microrobotics/ESP32-EASY-PROTO-V2/docs/images/ESP32-EASY-PROTO-V2_Assembled_T&B.jpg

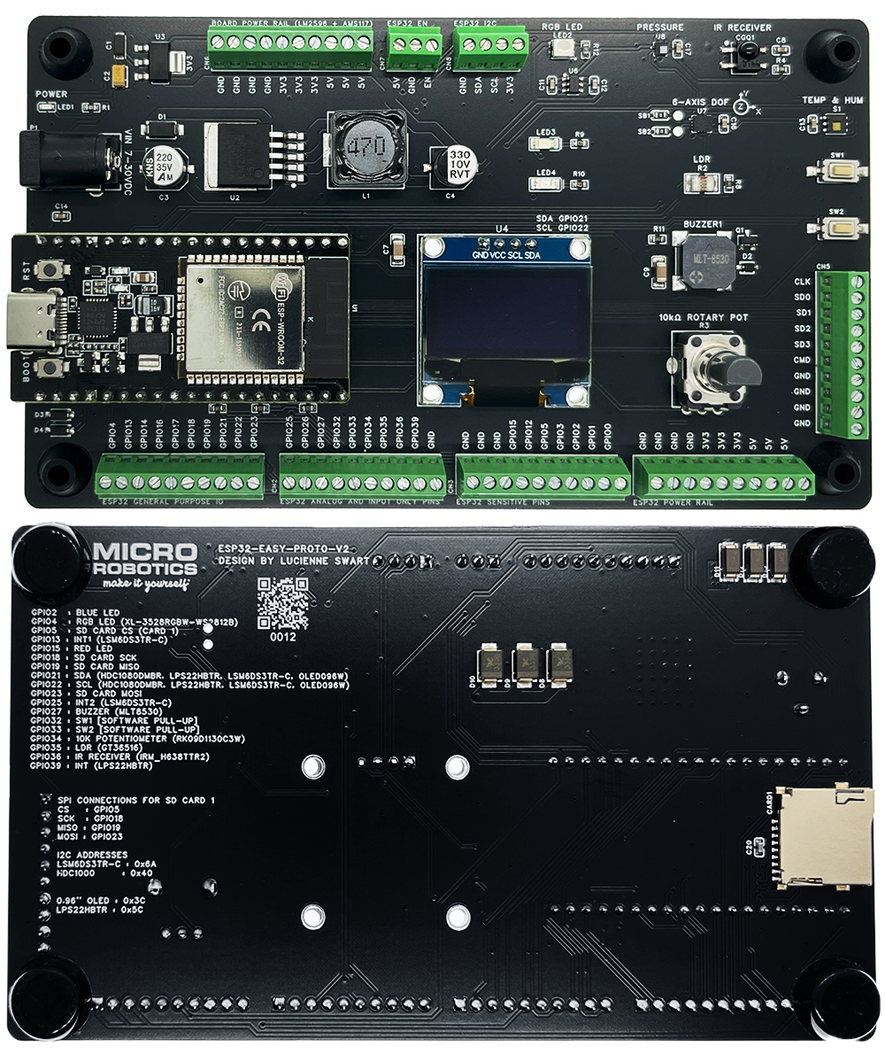
docs/images/ESP32-EASY-PROTO-V2_Assembled_T&B.jpg
