microrobotics/ESP32-EASY-PROTO-V2/hardware/mechanical/drawings/ESP32-EASY-PROTO-V2_Dimensions_and_Mounting_holes.png

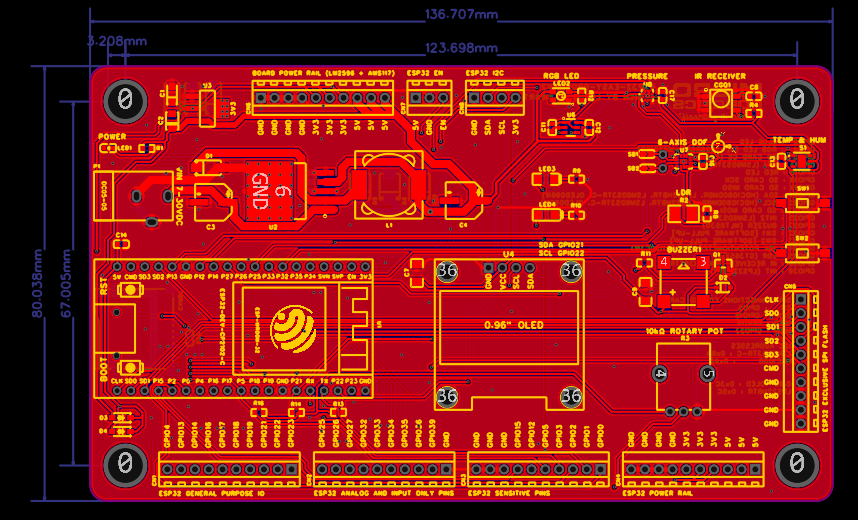
hardware/mechanical/drawings/ESP32-EASY-PROTO-V2_Dimensions_and_Mounting_holes.png
