microrobotics/ESP32-EASY-PROTO-V2/README.md

# ESP32-EASY-PROTO-V2

**Designed by:** Lucienne Swart, **Micro Robotics**  
**In Collaboration with:** University of Pretoria

ESP32-EASY-PROTO-FB

## Overview

This repository contains the hardware design files, firmware, documentation, and scripts for the **ESP32-EASY-PROTO-V2** board. The board is an educational and prototyping platform built around the ESP32-WROOM-32E module (Wi-Fi + Bluetooth), featuring multiple sensors (IMU, humidity, pressure), peripherals (OLED, SD card, buzzer, IR, WS2812B), and a flexible power design (7–30 V DC Jack and/or USB).

## Repository Structure

- **hardware/**  
  Schematic, PCB, and mechanical design files (Gerbers, BOM, 3D models).

- **firmware/**  
  Example code, projects for Arduino, PlatformIO, ESP-IDF, etc.

- **docs/**  
  Additional documentation, images, diagrams, and PDF manuals.

- **scripts/**  
  Utility scripts for manufacturing, testing, or other automation tasks.

- **LICENSE.md**  
  Proprietary notice and usage terms. (Board design is property of Micro Robotics.)

## Usage

1. **Clone or Download** this repository.  
2. Refer to [hardware/README.md](hardware/README.md) for hardware design details.  
3. Look in [firmware/README.md](firmware/README.md) for firmware setup and examples.  
4. Check [docs/README.md](docs/README.md) for additional documentation or images.

---

## License

This project is **proprietary** and not covered by any open-source license. See [LICENSE.md](LICENSE.md) for full details. Unauthorized copying, modification, or distribution of these design files is prohibited.

---

## Proprietary Documentation

Detailed technical documentation, including editable Word files, design files etc, is managed in a **private repository** for internal use.  

- [Access Private Repository](https://github.com/microrobotics/private.ESP32-EASY-PROTO-V2/tree/main) *(Access requires appropriate permissions)*  

For inquiries about accessing the private documentation, please contact **Micro Robotics** at support@microgroup.co.za.

---

## Contact & Support

- **Micro Robotics**: support@microgroup.co.za  
- GitHub Issues: Disabled
