microrobotics/ESP32-EASY-PROTO-V2/docs/README.md

# docs

Documentation, images, diagrams, and additional references for the **ESP32-EASY-PROTO-V2** board. **Proprietary**—see [../LICENSE.md](../LICENSE.md).

## Structure

- **images/**  
  - Photos, board diagrams, block diagrams, schematics screenshots, etc.
- **PDF/**  
  - Final user manual PDFs, datasheet references, or assembly guides.
- **source/**  
  - netlist.
