microrobotics/ESP32-EASY-PROTO-V2/scripts/README.md

# scripts

Utility scripts for the ESP32-EASY-PROTO-V2, **proprietary**—see [../LICENSE.md](../LICENSE.md).

## Potential Script Types

- **production_scripts/**  
  - BOM parsing, generating pick-and-place data, version stamping, etc.

- **test_scripts/**  
  - Automated test scripts for verifying sensor functionality or power rails.

## Guidelines

- Document any dependencies (Python libraries, shell environment).
- Provide sample usage in the script comments or here in the README.
