microrobotics/ESP32-EASY-PROTO-V2/hardware/mechanical/README.md

# hardware/mechanical

Mechanical design files, **if any**, for the ESP32-EASY-PROTO-V2. **Proprietary**—see [../../LICENSE.md](../../LICENSE.md).

## Contents

- **3D_models/**  
  - `.step`, `.stl`, or `.obj` files representing the board or custom enclosure.  
- **drawings/**  
  - Detailed dimension drawings or mounting hole references.

## Usage

- Enclosures: 3D-printed or laser-cut enclosure, place design files or plans here.  
- Mounting Info: The PCB has corner holes for rubber feet or enclosure screws
