microrobotics/ESP32-EASY-PROTO-V2/hardware/schematic/README.md

# hardware/schematic

This subdirectory contains **schematic files** for the ESP32-EASY-PROTO-V2 board.

## Contents

- **source/**  
  - Native schematic files (e.g., `.sch`, `.pro`, `.kicad_sch`, or `.dsn`).
- **PDF/**  
  - Exported schematic diagrams in PDF format for easy viewing.
- **README.md**  
  - (This file) Explains directory structure and version notes.

## Version / Revision History

- **V2.0**  
  - Initial release by Lucienne Swart, Micro Robotics.  
  - ESP32-WROOM-32E module, IMU, humidity, pressure, etc.

- **(Future)**  
  - Fix silkscreen error with GPIO36/39, add more protective measures, etc.

## How to Use

1. **Open Source Files**  
   - Use KiCad, Altium, Eagle, or whichever ECAD tool you prefer (depending on the file format).
2. **Check PDF**  
   - For a quick reference or printing.
