microrobotics/ESP32-EASY-PROTO-V2/docs/images/2D_ESP32-EASY-PROTO-V2_Top_2025-01-13.png

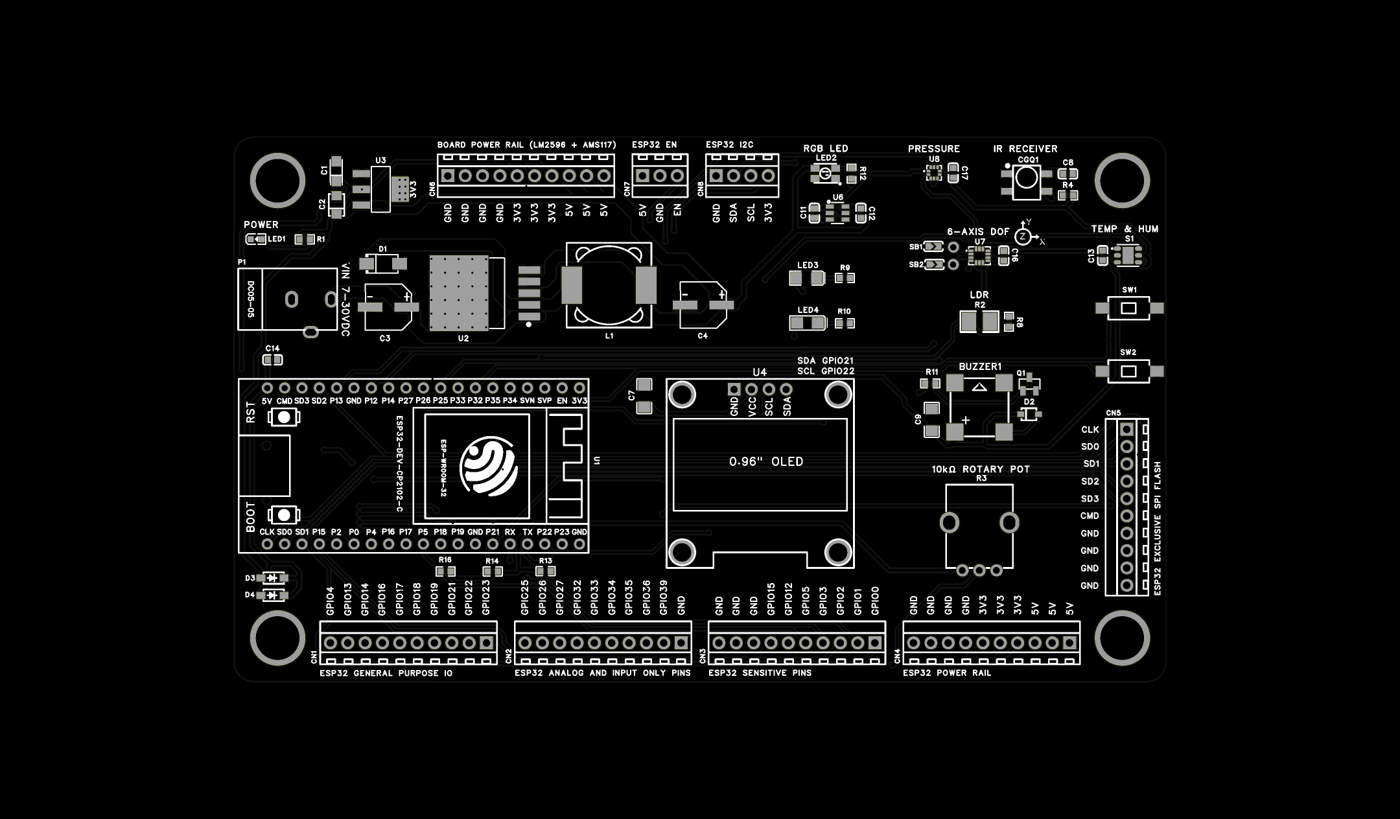
docs/images/2D_ESP32-EASY-PROTO-V2_Top_2025-01-13.png
