microrobotics/ESP32-EASY-PROTO-V2/docs/images/PCB_ESP32-EASY-PROTO-V2_Bottom_Screenshot.png

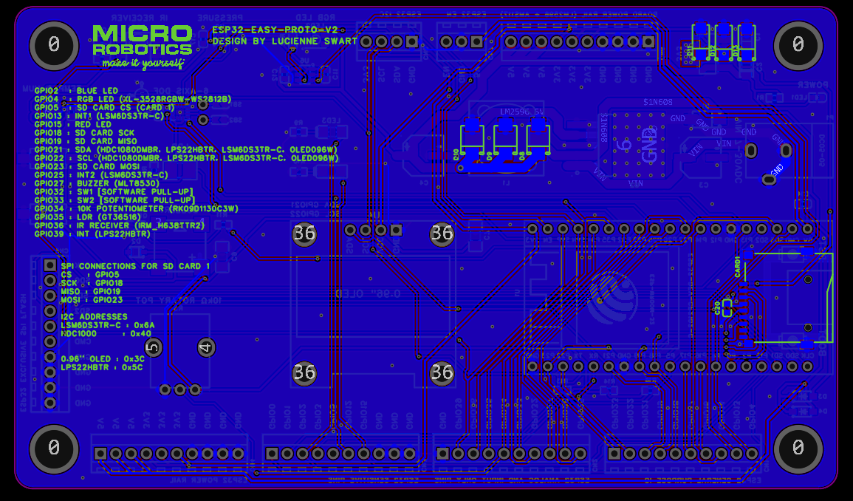
docs/images/PCB_ESP32-EASY-PROTO-V2_Bottom_Screenshot.png
