microrobotics/ESP32-EASY-PROTO-V2/hardware/BOM/BOM.xlsx

Comment | topDesignator | bottomDesignator | Footprint | JLCPCB Part #
TXB0101DBVR | U6 |  | SOT-23-6_L2.9-W1.6-P0.95-LS2.8-TL | C2652944
270Ω | R9,R10 |  | R0603 | C22966
1N4001WS | D2 |  | SOD-323_L1.6-W1.3-LS2.7-RD | C2898400
47uH | L1 |  | IND-SMD_L12.3-W12.3 | C7431082
LSM6DS3TR-C | U7 |  | LGA-14_L3.0-W2.5-P0.50-TL | C967633
SMBJ5339B |  | D8,D9,D10 | SMB_L4.6-W3.6-LS5.4-RD | C19077494
IRM-H638T/TR2 | CGQ1 |  | SENSOR-SMD_IRM-H638T-TR2-TL | C91447
10kΩ | R8,R11 |  | R0603 | C73809
HDC1080DMBR | S1 |  | SENSOR-SMD_HDC1080DMBR | C82227
GT36516 | R2 |  | RES-SMD_L3.6-W2.4 | C2904880
100uF | C7,C9 |  | C1206 | C15008
330uF | C4 |  | CAP-SMD_BD6.3-L6.6-W6.6-LS7.4-FD | C7419412
LPS22HBTR | U8 |  | HLGA-10L_LPS22HBTR | C94049
1N5819HW-MS | D3,D4 |  | SOD-123_L2.7-W1.6-LS3.7-RD-1 | C2995315
100nF | C11,C12,C13,C14,C16,C17 | C20 | C0603 | C519438
1.5kΩ | R1 |  | R0603 | C22843
HL-PC-3216H203BC | LED3 |  | LED1206-R-RD_BLUE | C500012
SS54 | D1 |  | SMA_L4.3-W2.6-LS5.0-RD | C727065
22uF | C1 |  | CAP-SMD_L3.2-W1.6-RD-1 | C124862
1SMA4729AG |  | D11,D12,D13 | SMA_L4.4-W2.6-LS5.0-RD | C433396
4.7uF | C8 |  | C0603 | C1705
220uF | C3 |  | CAP-SMD_BD6.3-L6.6-W6.6-FD | C7471881
100Ω | R4 |  | R0603 | C22775
AMS1117-3.3_C347222 | U3 |  | SOT-223-4_L6.5-W3.5-P2.30-LS7.0-BR | C347222
10uF | C2 |  | CAP-SMD_L3.2-W1.6 | C185774
XL-3528RGBW-WS2812B | LED2 |  | LED-SMD_4P-L3.5-W2.8-BR-1 | C2890364
SZYY1206R | LED4 |  | LED1206-RD-R_RED | C434438
330Ω | R12 |  | R0603 | C384242
2.7kHz | BUZZER1 |  | BUZ-SMD_4P-L8.5-W8.5-P8.50-BR | C94599
TS-1101-C-W | SW1,SW2 |  | SW-SMD_L6.0-W3.3-LS8.0 | C318938
TF-01A |  | CARD1 | TF-SMD_TF-01A | C91145
4.7kΩ | R13,R14 |  | R0603 | C23162
10kΩ | R16 |  | R0603 | C25804
JUMPERSOLDERBRIDGECOPYCOPY | SB1,SB2 |  | PAD-JUMPER-2-NC_BY_PASTE_YES_SILK | C21189
19-219/GHC-YR2T1B5Y/3T | LED1 |  | LED0603-RD_GREEN | C2994781
10kΩ | R3 |  | RES-ADJ-TH_RK09D1130C3C | C470315
LM2596S-5.0 | U2 |  | TO-263-5_L10.2-W8.9-P1.70-BR | C347421
2N7002 | Q1 |  | SOT-23-3_L2.9-W1.3-P1.90-LS2.4-BR | C389059
