microrobotics/ESP32-EASY-PROTO-V2/(list of files, cad)

Other CAD files:
hardware/mechanical/3D_models/3D_ESP32 -EASY-PROTO-V2_2025-01-08.step
