microrobotics/ESP32-EASY-PROTO-V2/CHANGELOG.md

# Changelog

All notable changes to the ESP32-EASY-PROTO-V2 project will be documented in this file.

## [2.0.0] - 2025-01-08
- Initial release by Lucienne Swart at Micro Robotics.
- PCB silkscreen includes known GPIO36↔GPIO39 swap error.
- Features: LSM6DS3, HDC1080, LPS22HB, etc.

## [2.1.0] - (Future)
- Correction of silkscreen errors, improved ESD measures, optional reverse voltage protection, PTC fuses, varistors, etc.
