microrobotics/ESP32-EASY-PROTO-V2/hardware/schematic/PDF/SCH_ESP32-EASY-PROTO-V2_ 2025_01_08.pdf

R16

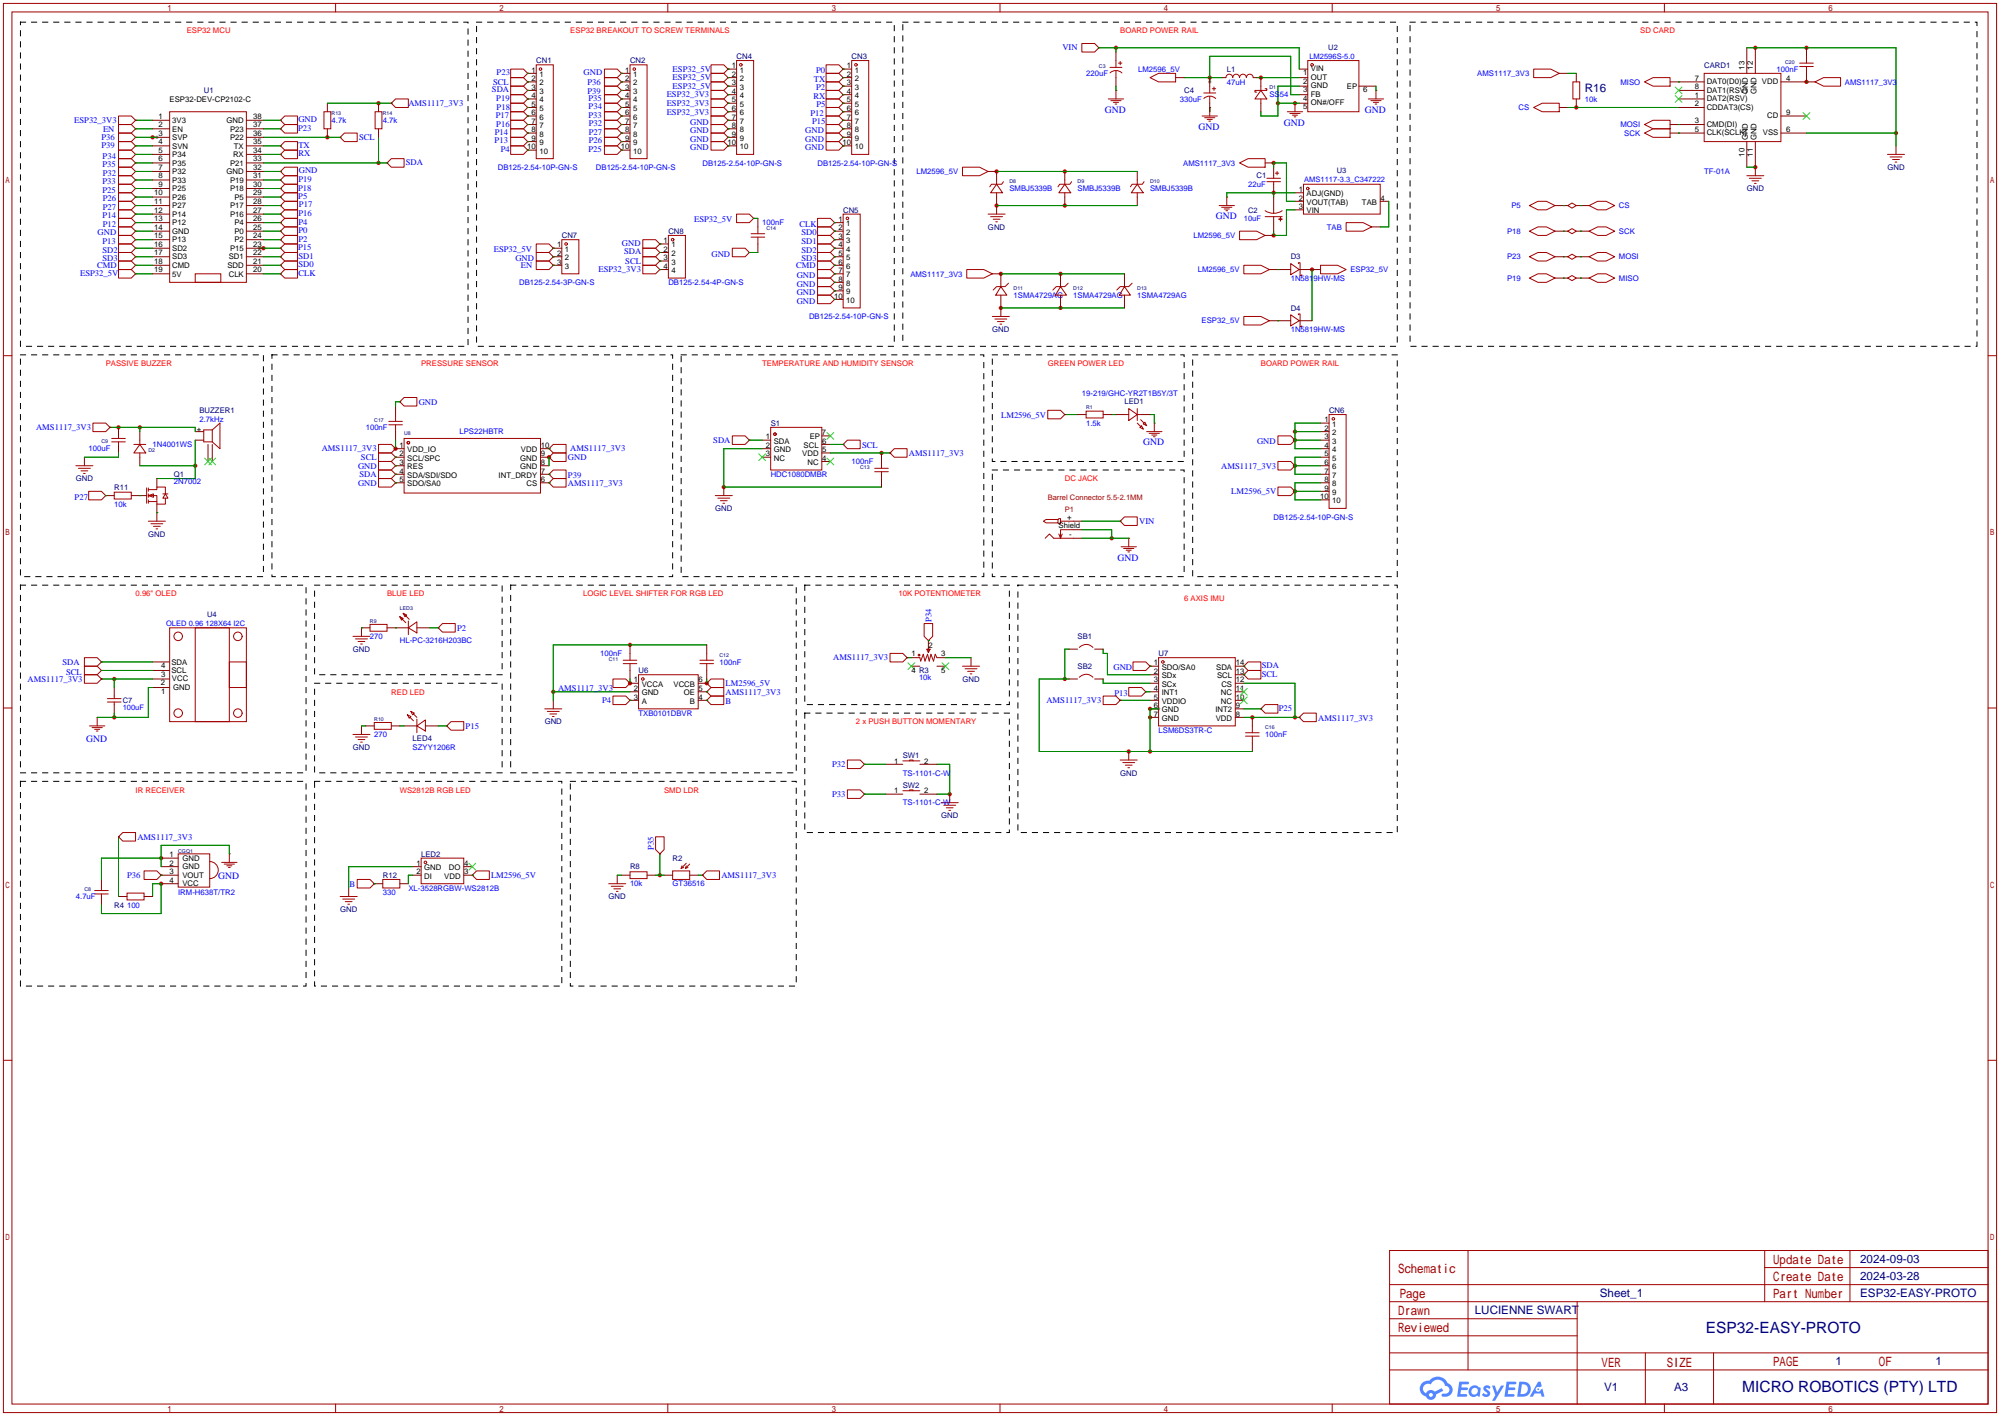
[picture p8: page 1]

TEMPERATURE AND HUMIDITY SENSOR

LOGIC LEVEL SHIFTER FOR RGB LED
