microrobotics/ESP32-EASY-PROTO-V2/(commit log)

2025-01-08 Create 3D_ESP32 -EASY-PROTO-V2_2025-01-08.step
    [3D_ESP32 -EASY-PROTO-V2_2025-01-08.step]
2025-01-08 Update and rename ESP32-EASY-PROTO_BUZZER.ino to ESP32-EASY-PROTO-V2_BUZZER.ino
2025-01-08 Update and rename ESP32-EASY-PROTO_IMU.ino to ESP32-EASY-PROTO-V2_IMU.ino
2025-01-08 Update and rename ESP32-EASY-PROTO_IR_RECEIVER.ino to ESP32-EASY-PROTO-V2_IR_RECEIVER.ino
2025-01-08 Update and rename ESP32-EASY-PROTO_LDR.ino to ESP32-EASY-PROTO-V2_LDR.ino
2025-01-08 Update and rename ESP32-EASY-PROTO_LEDS.ino to ESP32-EASY-PROTO-V2_LEDS.ino
2025-01-08 Update and rename ESP32-EASY-PROTO_POT.ino to ESP32-EASY-PROTO-V2_POT.ino
2025-01-08 Update and rename ESP32-EASY-PROTO_PRESSURE_SENSOR.ino to ESP32-EASY-PROTO-V2_PRESSURE_SENSOR.ino
2025-01-08 Update and rename ESP32-EASY-PROTO_PUSH_BUTTONS.ino to ESP32-EASY-PROTO-V2_PUSH_BUTTONS.ino
2025-01-08 Update and rename ESP32-EASY-PROTO_RGB_LED.ino to ESP32-EASY-PROTO-V2_RGB_LED.ino
2025-01-08 Update and rename ESP32-EASY-PROTO_TEMP_HUM_SENSOR.ino to ESP32-EASY-PROTO-V2_TEMP_HUM_SENSOR.ino
